thilinasGit/VegaLogger/README.md

# VegaLogger
This repo contains files that is used in telemetery data logger originally used in Vega ETX.
