thilinasGit/VegaLogger/plantFeedpcbModifications.pdf

## Modifications to plant feed board

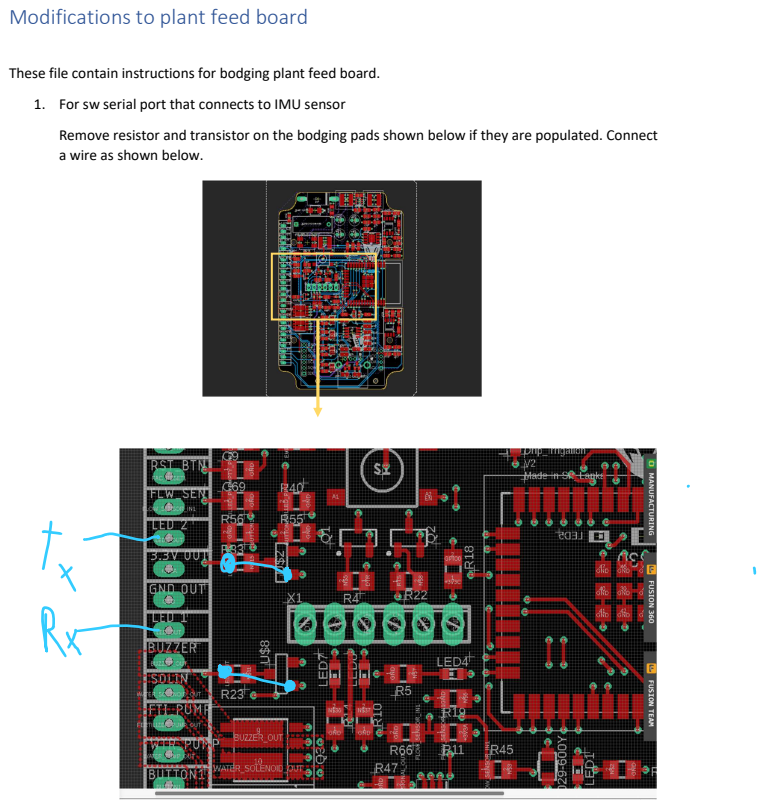
[picture p1: page 1]

These file contain instructions for bodging plant feed board.
1. For sw serial port that connects to IMU sensor
Remove resistor and transistor on the bodging pads shown below if they are populated. Connect
a wire as shown below.

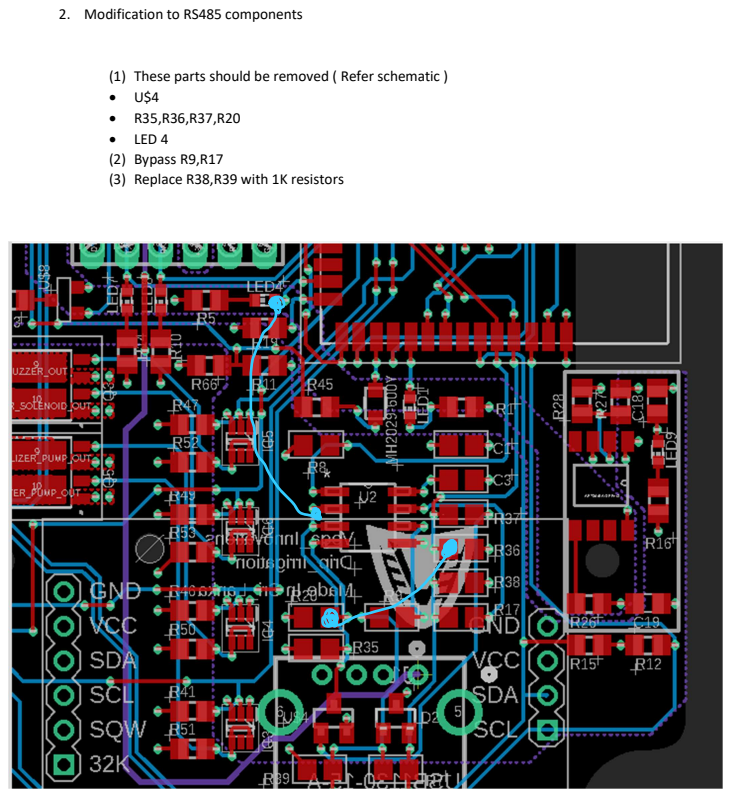
[picture p2: page 2]

2. Modification to RS485 components

(1) These parts should be removed ( Refer schematic )
LED 4
(2) Bypass R9,R17
(3) Replace R38,R39 with 1K resistors
