thilinasGit/VegaLogger/Final.brd

## EAGLE design Final.brd (2023-10-18)

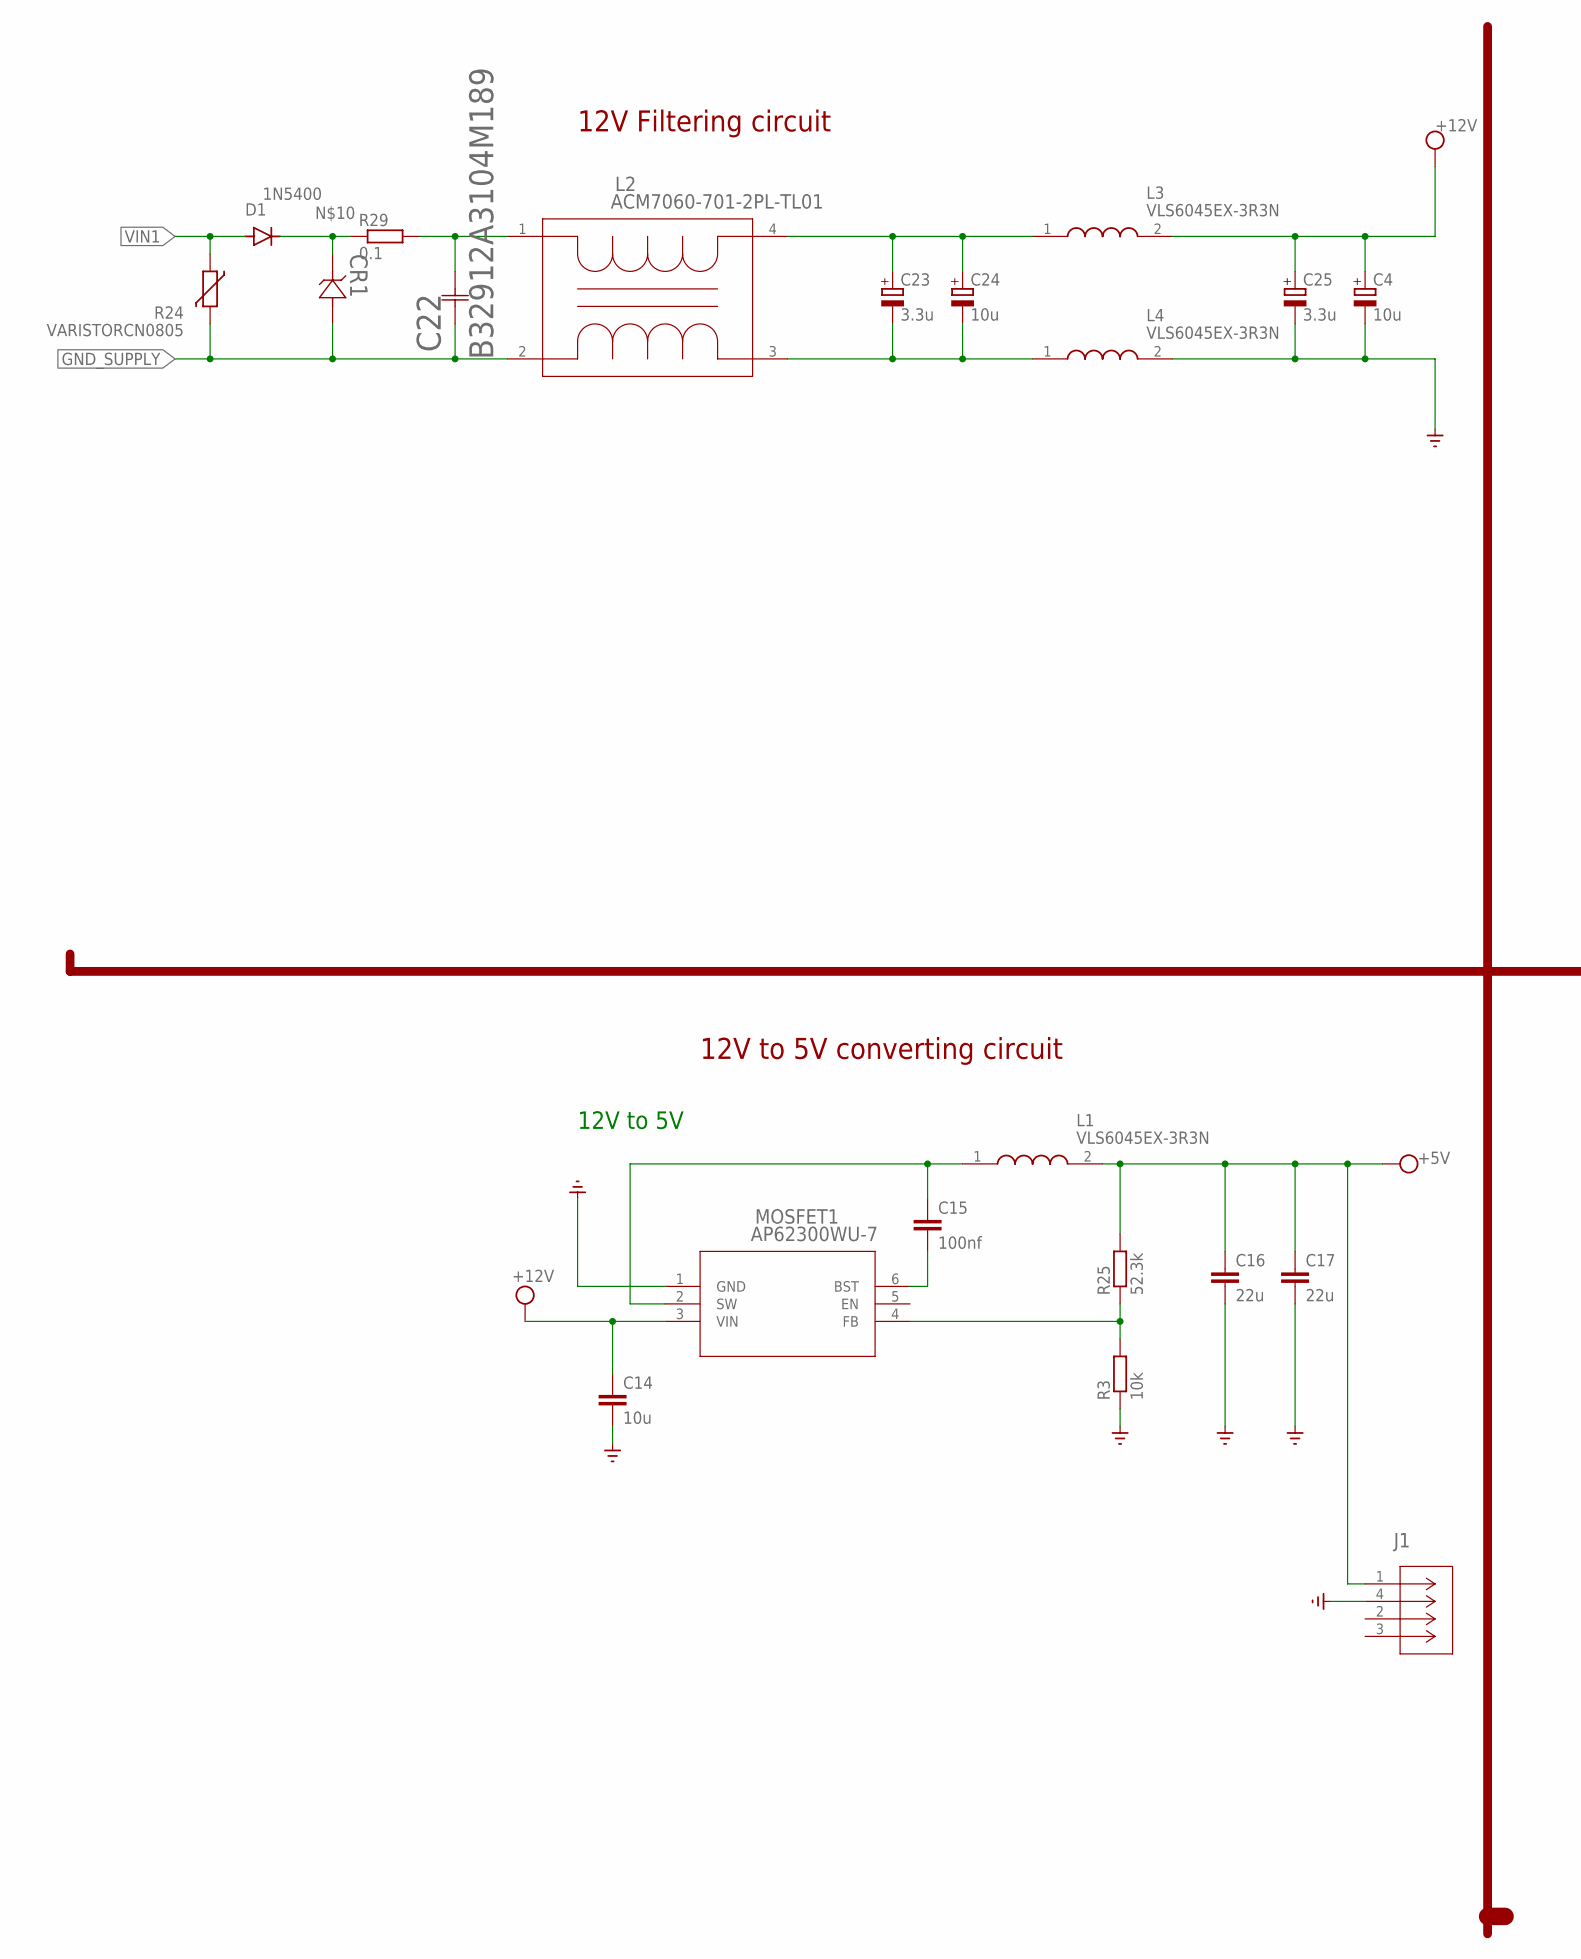
[picture p3: schematic Final.sch, sheet 1, POWER, part in row 1, column 1]

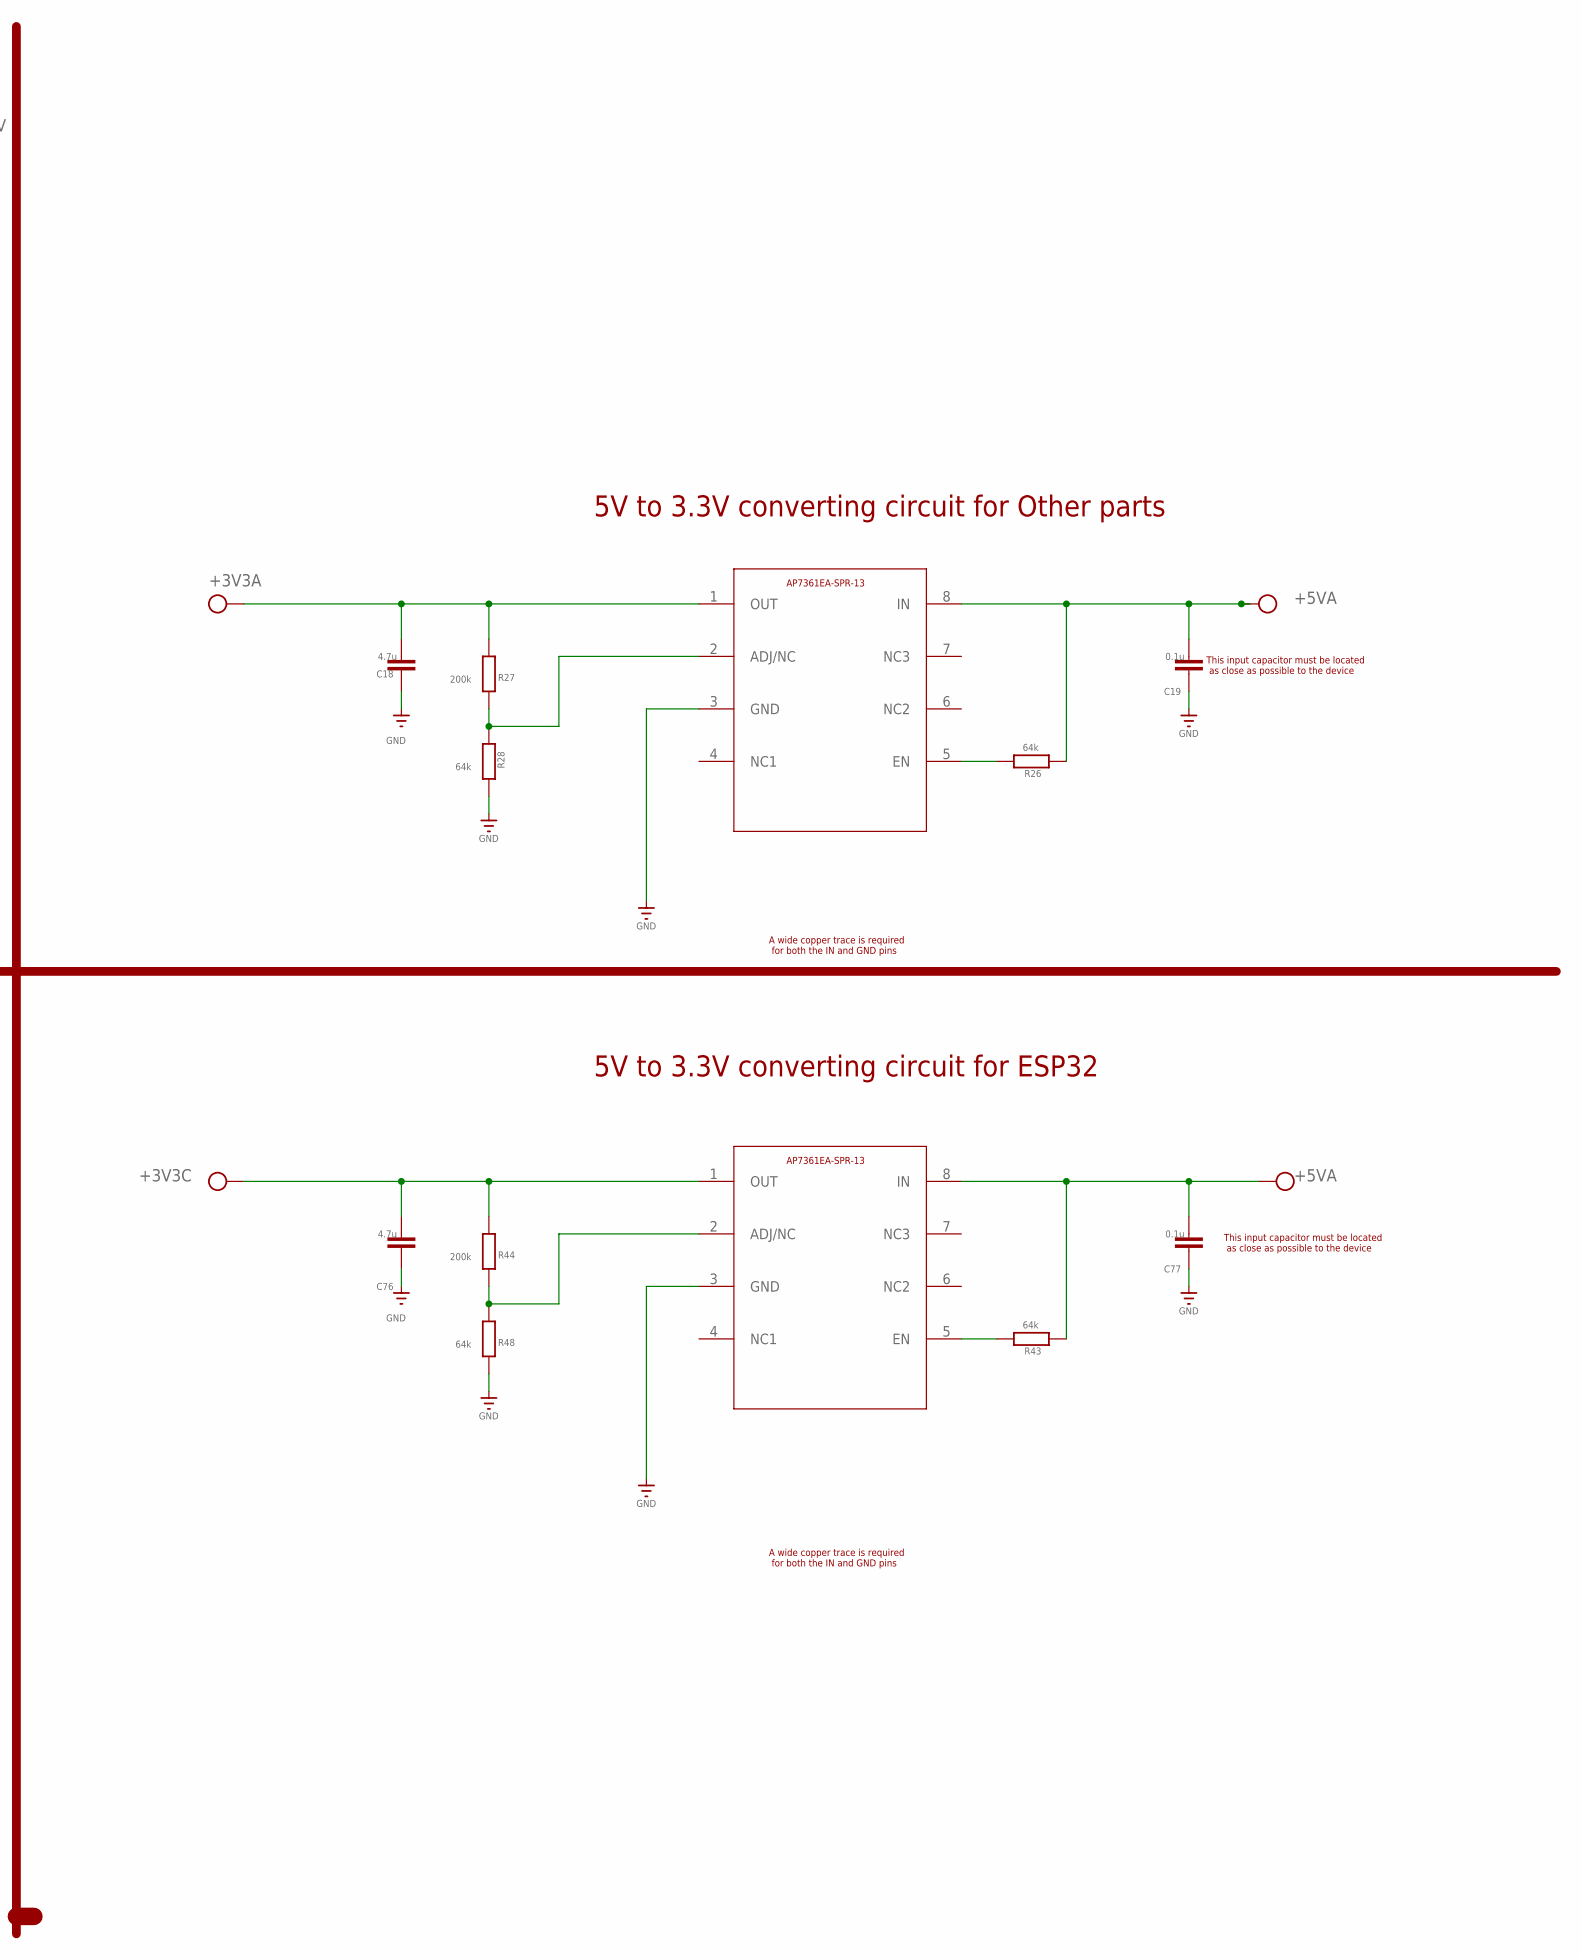
[picture p4: schematic Final.sch, sheet 1, POWER, part in row 1, column 2]

Parts:
C4, C24: 10u; E2,5-5
C14: 10u; C0805
C15: 100nf; C0805
C16, C17: 22u; C0805
C18, C76: 4.7u; C0805
C19, C77: 0.1u; C0805
C22: B32912A3104M189; CAP_B32912A--15--7X12.5X18_TDK
C23, C25: 3.3u; E2,5-5
CR1: SM6T15ASMB_STM-L; SMB_STM-L
D1: 1N5400; DO201-15
J1: USB1130-15-A; CONN4_USB1130-15-A_GCT
L1, L3, L4: VLS6045EX-3R3N; VLS6045
L2: ACM7060-701-2PL-TL01; IND_ACM7060_TDK
MOSFET1: AP62300WU-7; TSOT26_DIO
R3: 10k; R0805
R24: VARISTORCN0805; CT/CN0805
R25: 52.3k; R0805
R26, R28, R43, R48: 64k; R0805
R27, R44: 200k; R0805
R29: 0.1; R1206
U$1, U$12: AP7361EASMD; AP7361EA

Connections:
+3V3A: C18.1, R27.1, U$1.1 (OUT); also elsewhere on the board
+3V3C: C76.1, R44.1, U$12.1 (OUT); also elsewhere on the board
+5V: C16.1, C17.1, J1.1, L1.2, R25.2; also elsewhere on the board
+5VA: C19.1, C77.1, R26.1, R43.1, U$1.8 (IN), U$12.8 (IN); also elsewhere on the board
+12V: C4.+, C14.1, C25.+, L3.2, MOSFET1.3 (VIN); also elsewhere on the board
GND: C4.-, C14.2, C16.2, C17.2, C18.2, C19.2, C25.-, C76.2, C77.2, J1.4, L4.2, MOSFET1.1 (GND), R3.1, R28.2, R48.2, U$1.3 (GND), U$12.3 (GND); also elsewhere on the board
GND_SUPPLY: C22.1, CR1.2, L2.2, R24.2; also elsewhere on the board
unnamed: CR1.1, D1.C, R29.1
unnamed: C23.+, C24.+, L2.4, L3.1
unnamed: C23.-, C24.-, L2.3, L4.1
unnamed: MOSFET1.4 (FB), R3.2, R25.1
unnamed: C15.1, L1.1, MOSFET1.2 (SW)
unnamed: C15.2, MOSFET1.6 (BST)
unnamed: R26.2, U$1.5 (EN)
unnamed: R27.2, R28.1, U$1.2 (ADJ/NC)
unnamed: R43.2, U$12.5 (EN)
unnamed: R44.2, R48.1, U$12.2 (ADJ/NC)
VIN: C22.2, L2.1, R29.2
VIN1: D1.A, R24.1; also elsewhere on the board

Notes on the sheet:
12V to 5V
This input capacitor must be located as close as possible to the device
A wide copper trace is required for both the IN and GND pins
12V Filtering circuit
12V to 5V converting circuit
5V to 3.3V converting circuit for ESP32
5V to 3.3V converting circuit for Other parts

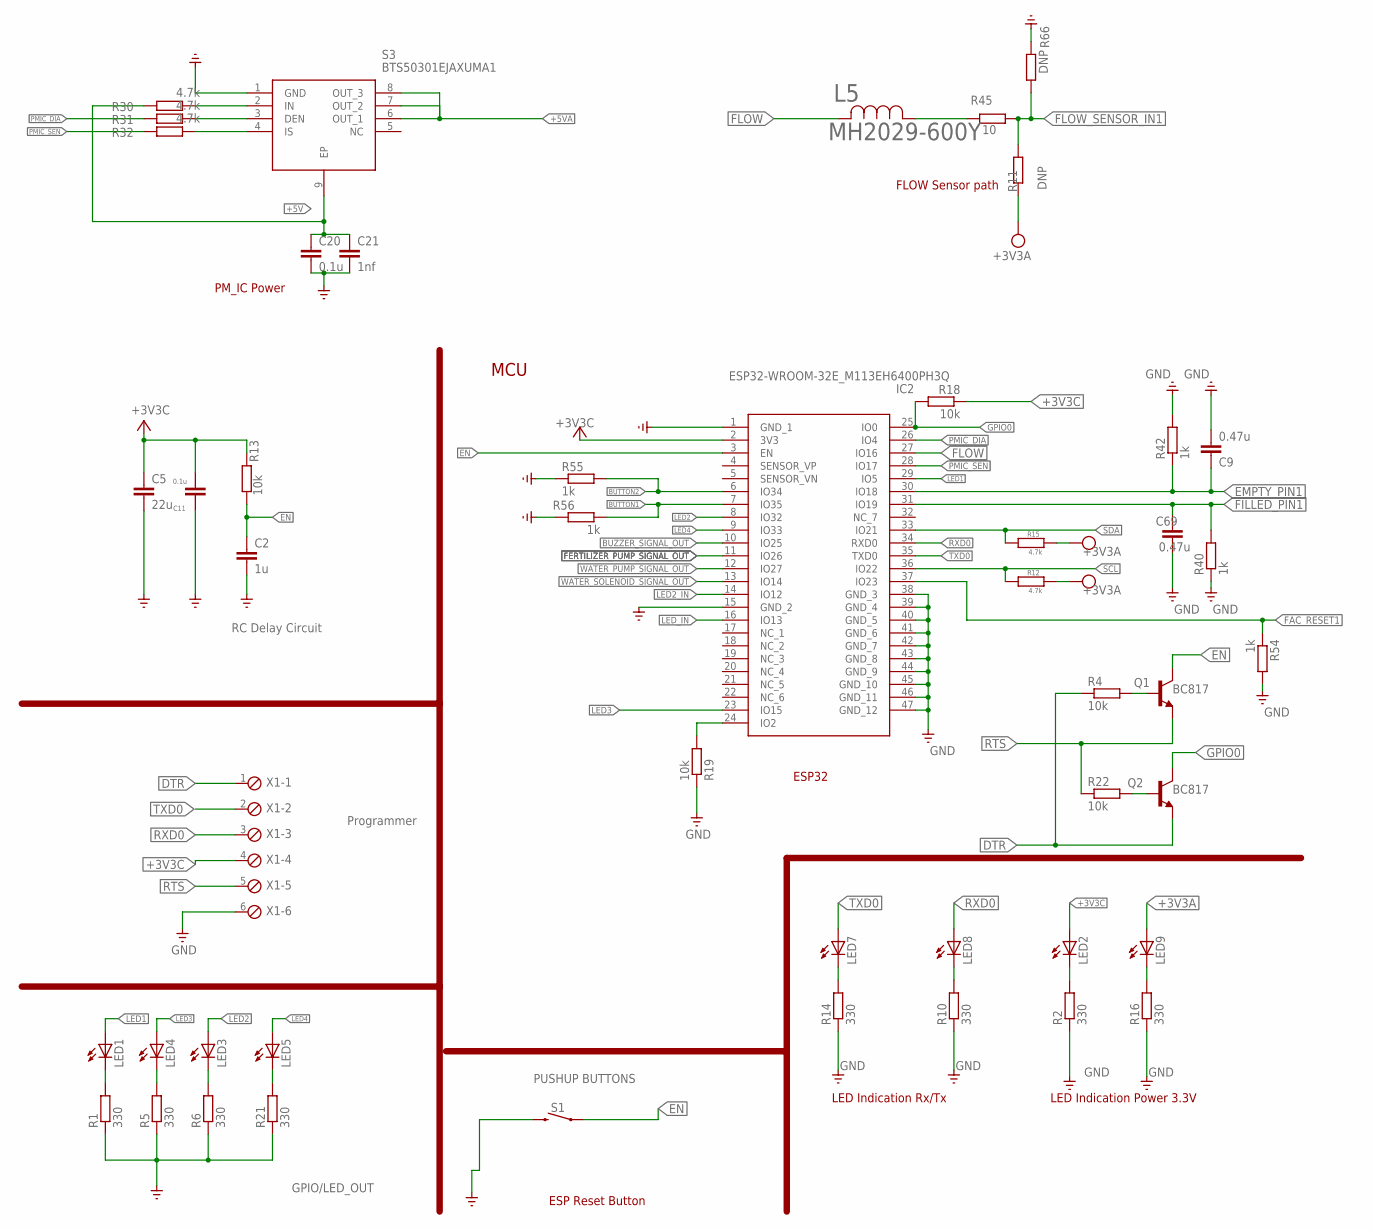
[picture p5: schematic Final.sch, sheet 2, ESP32]

Parts:
C2: 1u; C0805
C5: 22u; C0805
C9, C69: 0.47u; C0805
C11, C20: 0.1u; C0805
C21: 1nf; C0805
IC2: ESP32-WROOM-32E_M113EH6400PH3Q; ESP32WROOM32EM113EH6400PH3Q0
L5: MH2029-600Y; IND_BOURNS_MH2029
LED1, LED2, LED3, LED4, LED5, LED7, LED8, LED9: LEDCHIP-LED0603; CHIP-LED0603
Q1, Q2: BC817; SOT95P230X110-3N
R1, R2, R5, R6, R10, R14, R16, R21: 330; R0805
R4, R13, R18, R19, R22: 10k; R0805
R11, R66: DNP; R0805
R12, R15, R30, R31, R32: 4.7k; R0805
R40, R42, R54, R55, R56: 1k; R0805
R45: 10; R0805
S1: MOMENTARY-SWITCH-SPST-SMD-6.2MM-TALL; TACTILE_SWITCH_SMD_6.2MM_TALL
S3: BTS50301EJAXUMA1; SOIC127P600X170-9N
X1: MPT6; 6POL254

Connections:
+3V3A: LED9.A, R11.2, R12.1, R15.1; also elsewhere on the board
+3V3C: C5.1, C11.2, IC2.2 (3V3), LED2.A, R13.1, R18.1, X1.4; also elsewhere on the board
+5V: C20.1, C21.1, R30.1, S3.9 (EP); also elsewhere on the board
+5VA: S3.6 (OUT_1), S3.7 (OUT_2), S3.8 (OUT_3); also elsewhere on the board
BUTTON1: IC2.7 (IO35), R56.1; also elsewhere on the board
BUTTON2: IC2.6 (IO34), R55.2; also elsewhere on the board
BUZZER_SIGNAL_OUT: IC2.10 (IO25); also elsewhere on the board
DTR: Q2.2 (E), R4.1, X1.1
EMPTY_PIN1: C9.1, IC2.30 (IO18), R42.1; also elsewhere on the board
EN: C2.1, IC2.3 (EN), Q1.3 (C), R13.2, S1.A2 (1)
FAC_RESET1: IC2.37 (IO23), R54.1; also elsewhere on the board
FERTILIZER_PUMP_SIGNAL_OUT: IC2.11 (IO26); also elsewhere on the board
FILLED_PIN1: C69.1, IC2.31 (IO19), R40.2; also elsewhere on the board
FLOW: IC2.27 (IO16), L5.2
FLOW_SENSOR_IN1: R11.1, R45.1, R66.1; also elsewhere on the board
GND: C2.2, C5.2, C9.2, C11.1, C20.2, C21.2, C69.2, IC2.1 (GND_1), IC2.15 (GND_2), IC2.38 (GND_3), IC2.39 (GND_4), IC2.40 (GND_5), IC2.41 (GND_6), IC2.42 (GND_7), IC2.43 (GND_8), IC2.44 (GND_9), IC2.45 (GND_10), IC2.46 (GND_11), IC2.47 (GND_12), R1.1, R2.1, R5.1, R6.1, R10.1, R14.1, R16.1, R19.1, R21.1, R40.1, R42.2, R54.2, R55.1, R56.2, R66.2, S1.B2 (2), S3.1 (GND), X1.6; also elsewhere on the board
GPIO0: IC2.25 (IO0), Q2.3 (C), R18.2
LED1: IC2.29 (IO5), LED1.A
LED2: IC2.8 (IO32), LED3.A
LED2_IN: IC2.14 (IO12); also elsewhere on the board
LED3: IC2.23 (IO15), LED4.A
LED4: IC2.9 (IO33), LED5.A
LED_IN: IC2.16 (IO13); also elsewhere on the board
unnamed: LED2.C, R2.2
unnamed: LED1.C, R1.2
unnamed: L5.1, R45.2
unnamed: LED3.C, R6.2
unnamed: Q1.1 (B), R4.2
unnamed: IC2.24 (IO2), R19.2
unnamed: LED4.C, R5.2
unnamed: Q2.1 (B), R22.2
unnamed: LED5.C, R21.2
unnamed: R30.2, S3.2 (IN)
unnamed: R31.2, S3.3 (DEN)
unnamed: R32.2, S3.4 (IS)
unnamed: LED7.C, R14.2
unnamed: LED8.C, R10.2
unnamed: LED9.C, R16.2
PMIC_DIA: IC2.26 (IO4), R31.1
PMIC_SEN: IC2.28 (IO17), R32.1
RTS: Q1.2 (E), R22.1, X1.5
RXD0: IC2.34 (RXD0), LED8.A, X1.3; also elsewhere on the board
SCL: IC2.36 (IO22), R12.2; also elsewhere on the board
SDA: IC2.33 (IO21), R15.2; also elsewhere on the board
TXD0: IC2.35 (TXD0), LED7.A, X1.2; also elsewhere on the board
WATER_PUMP_SIGNAL_OUT: IC2.12 (IO27); also elsewhere on the board
WATER_SOLENOID_SIGNAL_OUT: IC2.13 (IO14); also elsewhere on the board

Notes on the sheet:
GPIO/LED_OUT
RC Delay Circuit
LED Indication Power 3.3V
PUSHUP BUTTONS
MCU
Programmer
LED Indication Rx/Tx
ESP Reset Button
ESP32
PM_IC Power
FLOW Sensor path

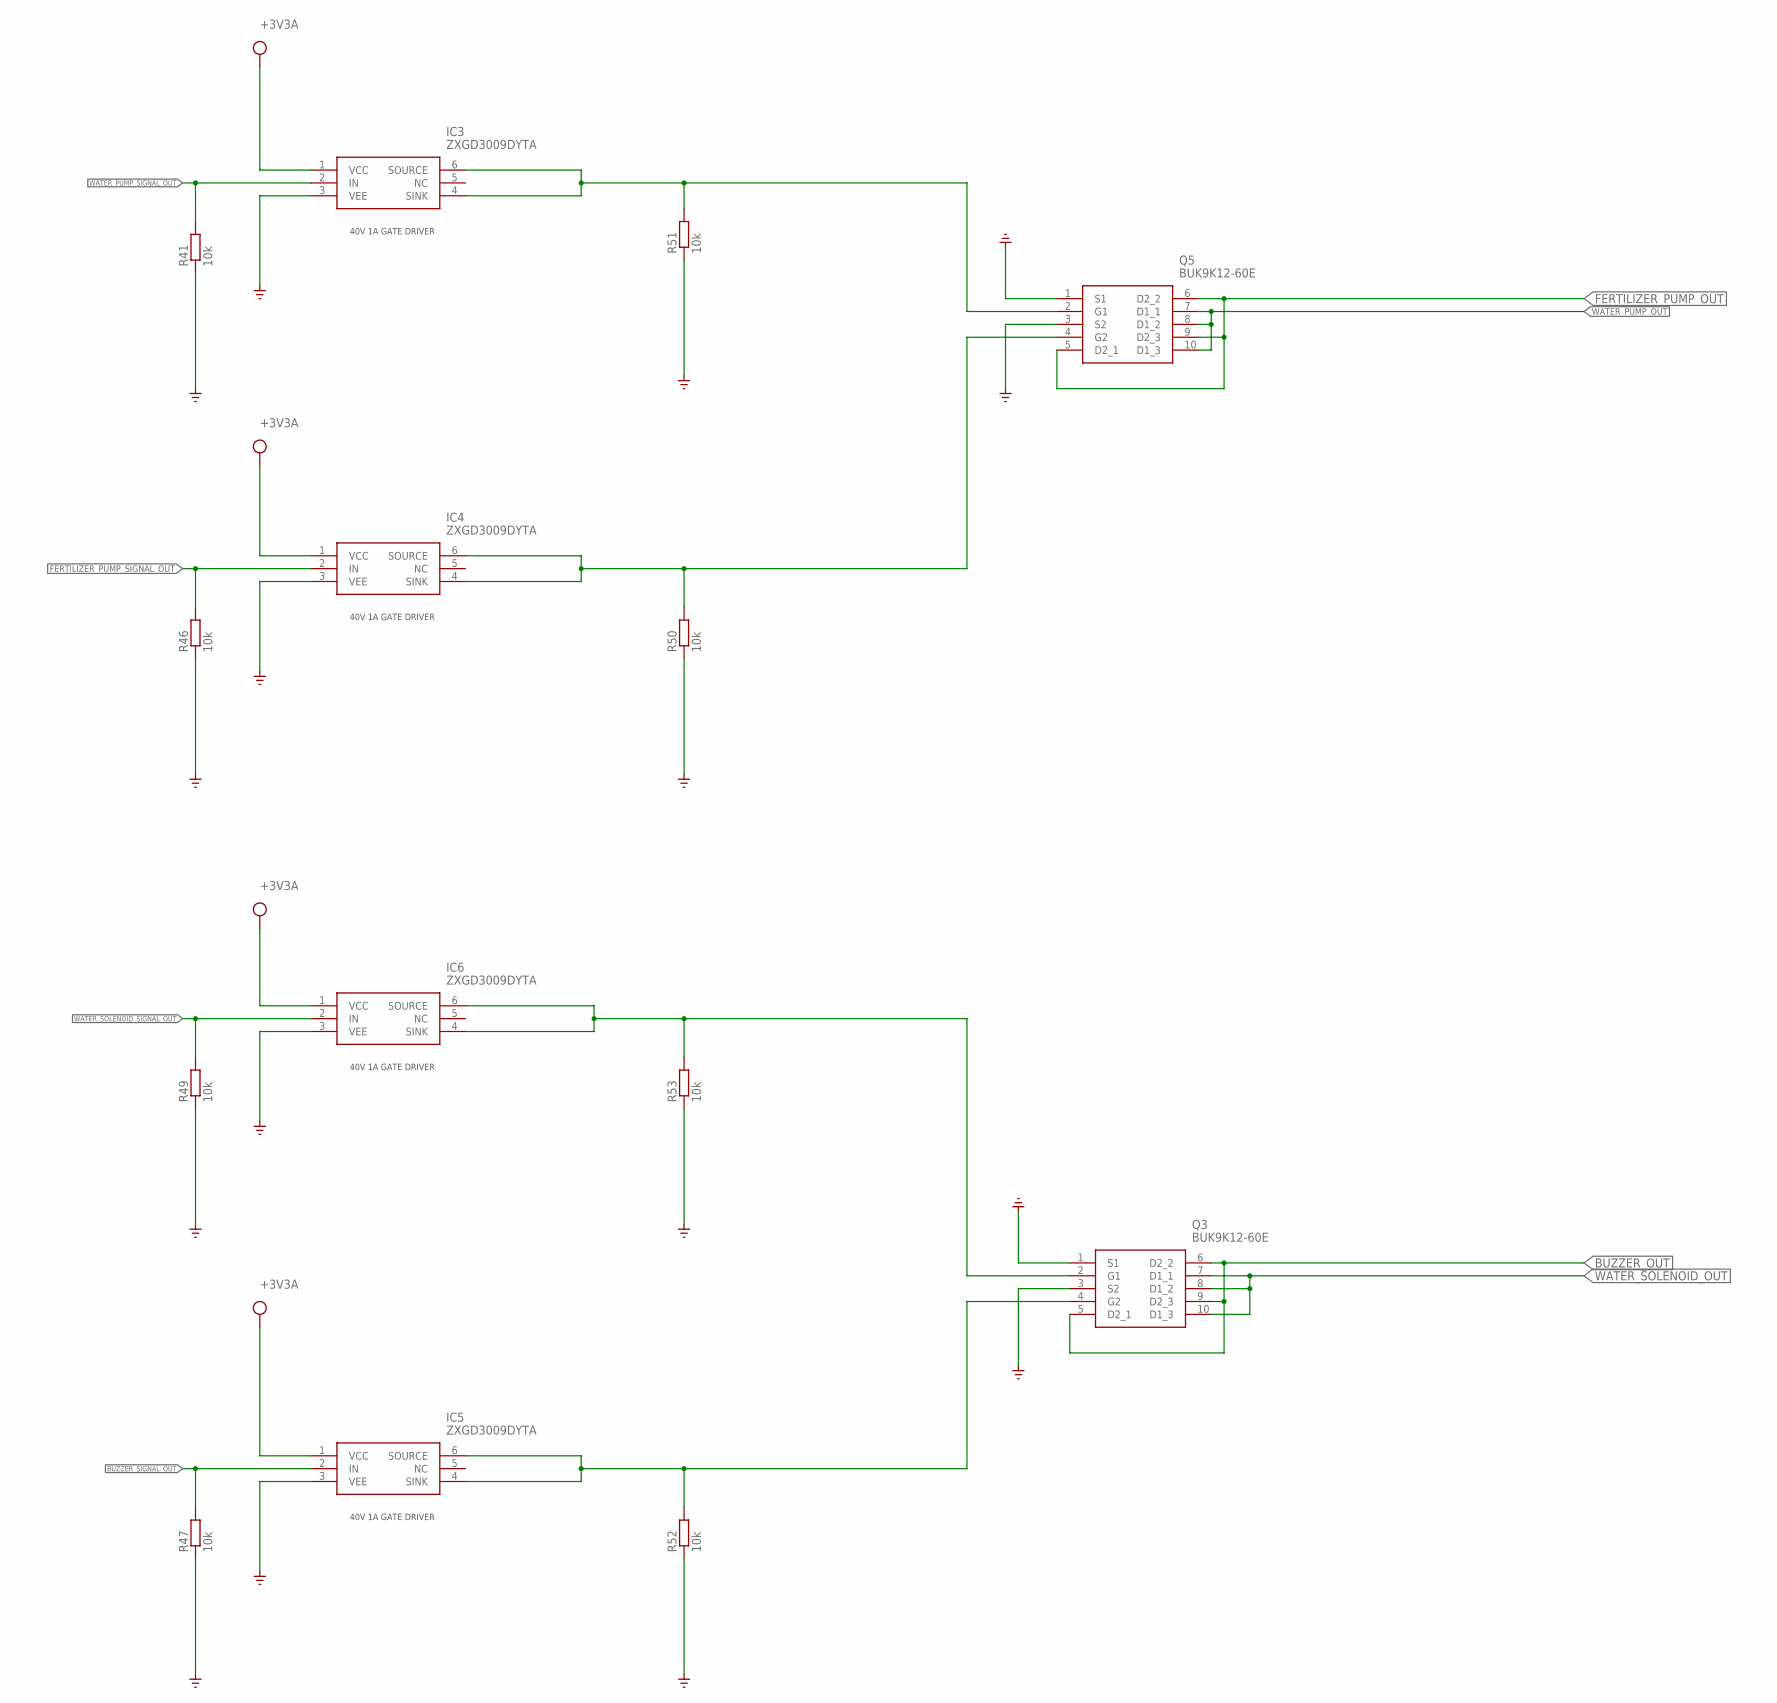
[picture p6: schematic Final.sch, sheet 3, Drivers]

Parts:
IC3, IC4, IC5, IC6: ZXGD3009DYTA; SOT65P210X110-6N
Q3, Q5: BUK9K12-60E
R41, R46, R47, R49, R50, R51, R52, R53: 10k; R0805

Connections:
+3V3A: IC3.1 (VCC), IC4.1 (VCC), IC5.1 (VCC), IC6.1 (VCC); also elsewhere on the board
BUZZER_OUT: Q3.5 (D2_1), Q3.6 (D2_2), Q3.9 (D2_3); also elsewhere on the board
BUZZER_SIGNAL_OUT: IC5.2 (IN), R47.2; also elsewhere on the board
FERTILIZER_PUMP_OUT: Q5.5 (D2_1), Q5.6 (D2_2), Q5.9 (D2_3); also elsewhere on the board
FERTILIZER_PUMP_SIGNAL_OUT: IC4.2 (IN), R46.2; also elsewhere on the board
GND: IC3.3 (VEE), IC4.3 (VEE), IC5.3 (VEE), IC6.3 (VEE), Q3.1 (S1), Q3.3 (S2), Q5.1 (S1), Q5.3 (S2), R41.1, R46.1, R47.1, R49.1, R50.1, R51.1, R52.1, R53.1; also elsewhere on the board
unnamed: IC3.4 (SINK), IC3.6 (SOURCE), Q5.2 (G1), R51.2
unnamed: IC4.4 (SINK), IC4.6 (SOURCE), Q5.4 (G2), R50.2
unnamed: IC5.4 (SINK), IC5.6 (SOURCE), Q3.4 (G2), R52.2
SOLENOID: IC6.4 (SINK), IC6.6 (SOURCE), Q3.2 (G1), R53.2
WATER_PUMP_OUT: Q5.7 (D1_1), Q5.8 (D1_2), Q5.10 (D1_3); also elsewhere on the board
WATER_PUMP_SIGNAL_OUT: IC3.2 (IN), R41.2; also elsewhere on the board
WATER_SOLENOID_OUT: Q3.7 (D1_1), Q3.8 (D1_2), Q3.10 (D1_3); also elsewhere on the board
WATER_SOLENOID_SIGNAL_OUT: IC6.2 (IN), R49.2; also elsewhere on the board

Notes on the sheet:
40V 1A GATE DRIVER

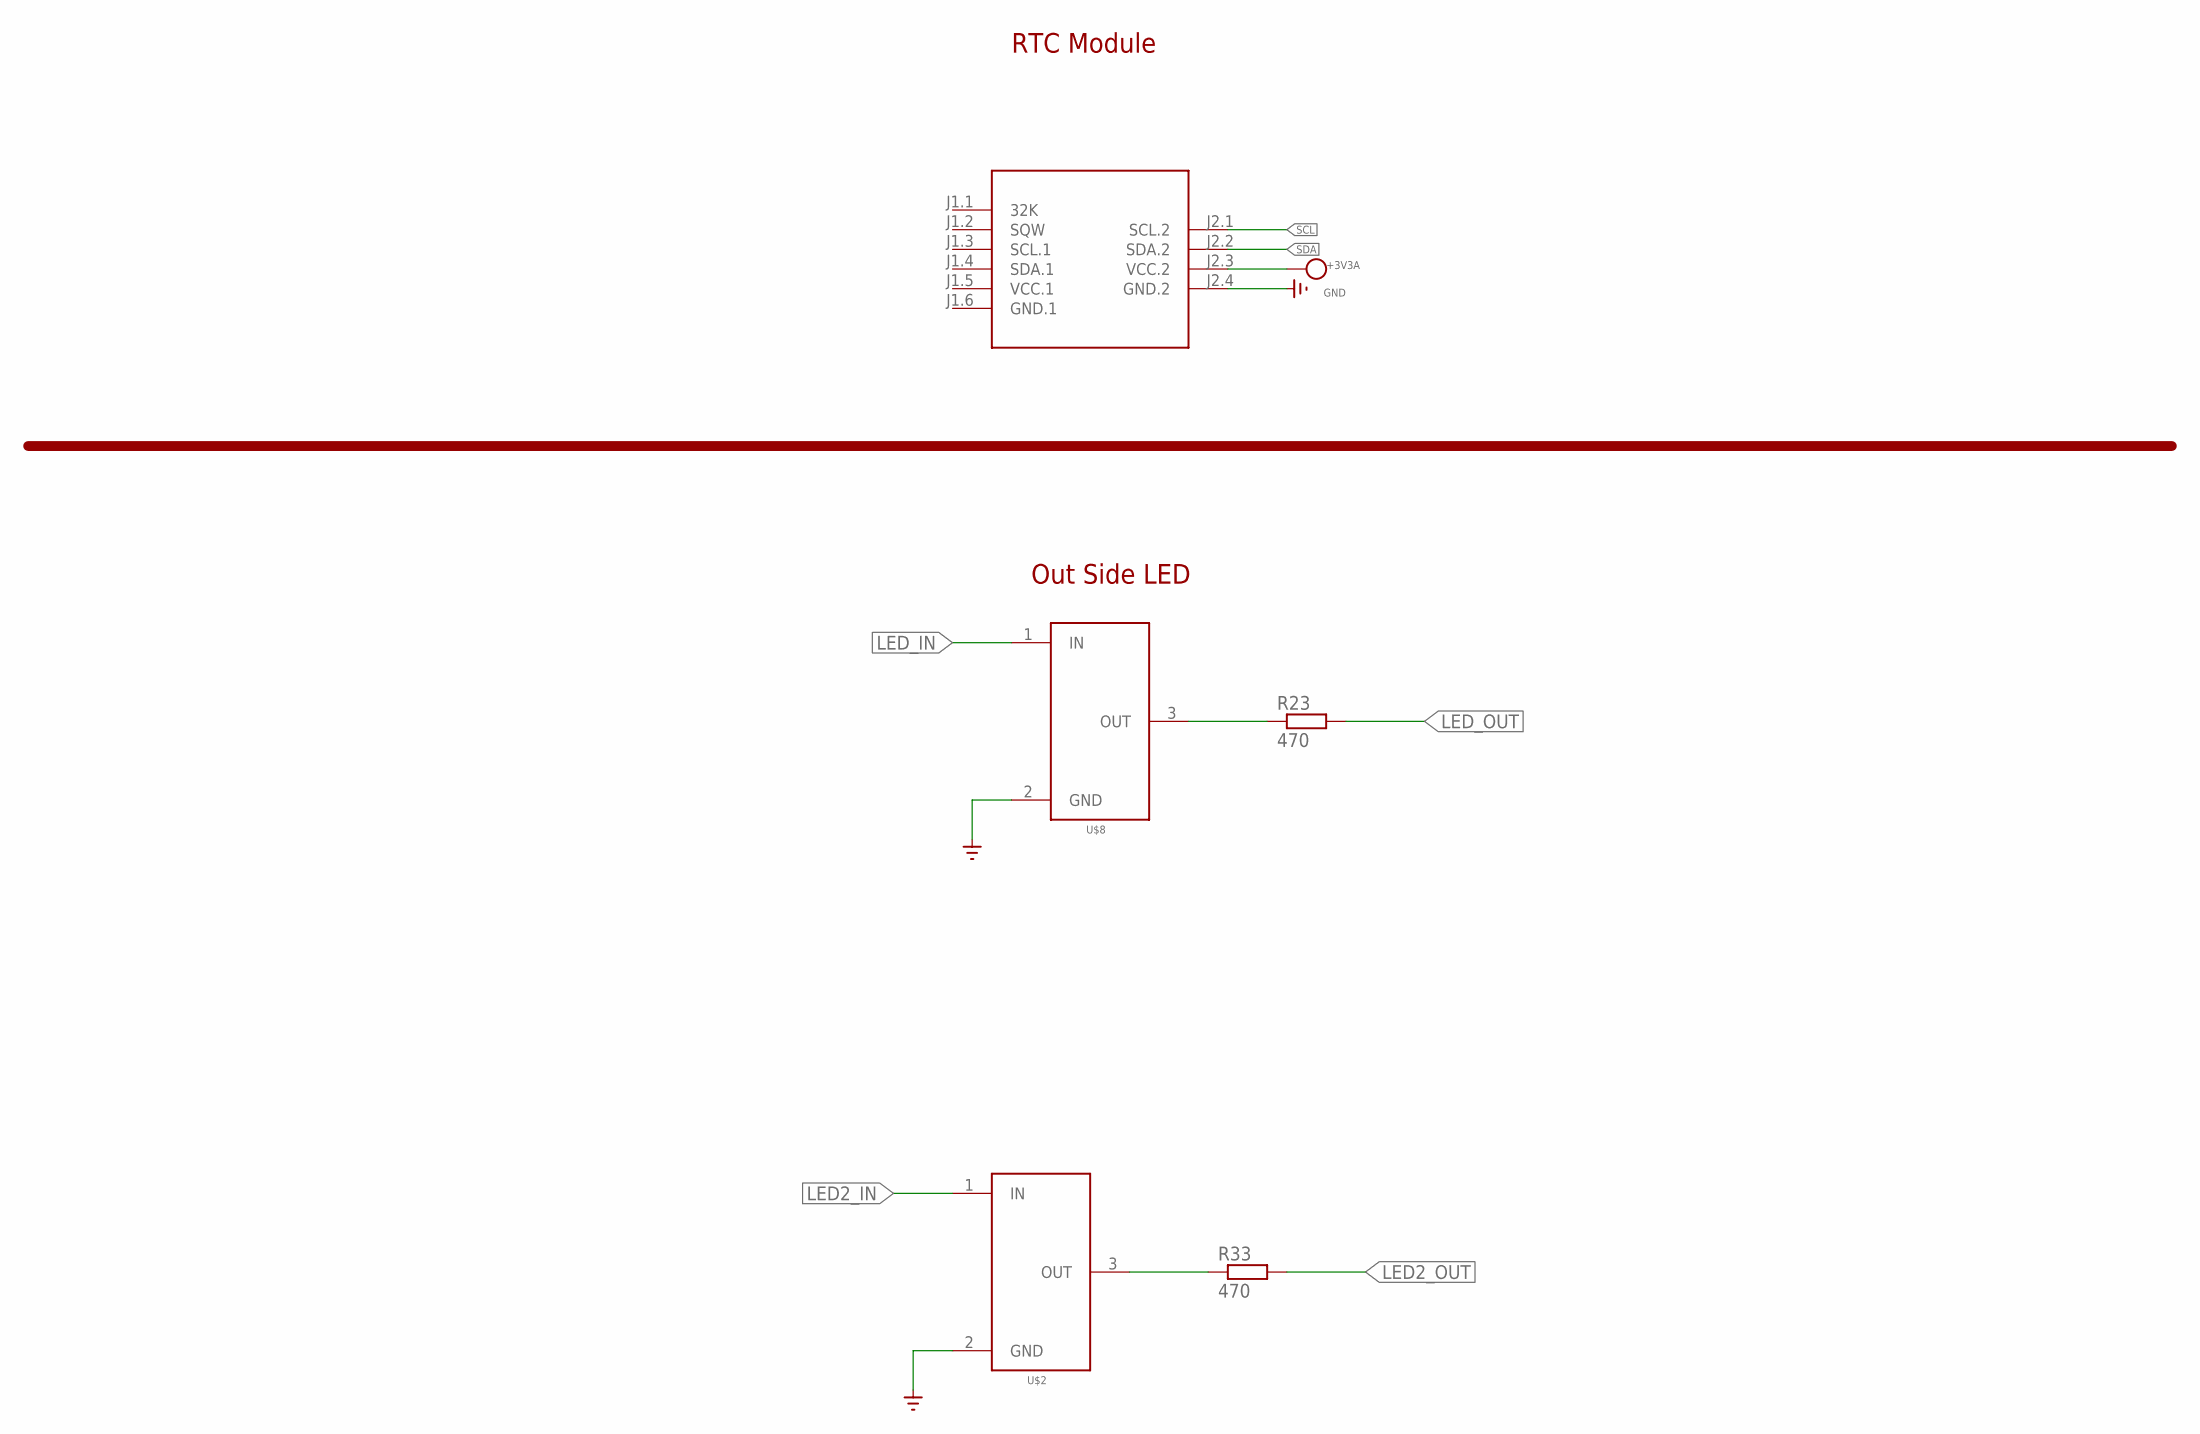
[picture p7: schematic Final.sch, sheet 4, RTC Module]

Parts:
R23, R33: 470; R0805
U$2, U$8: DDTD113ZC-7-F
U$3: RTC-DS3231-AT24C32

Connections:
+3V3A: U$3.J2.3 (VCC.2); also elsewhere on the board
GND: U$2.2 (GND), U$3.J2.4 (GND.2), U$8.2 (GND); also elsewhere on the board
GND.1: U$3.J1.6 (GND.1)
LED2_IN: U$2.1 (IN); also elsewhere on the board
LED2_OUT: R33.2; also elsewhere on the board
LED_IN: U$8.1 (IN); also elsewhere on the board
LED_OUT: R23.2; also elsewhere on the board
unnamed: R23.1, U$8.3 (OUT)
unnamed: R33.1, U$2.3 (OUT)
SCL: U$3.J2.1 (SCL.2); also elsewhere on the board
SDA: U$3.J2.2 (SDA.2); also elsewhere on the board
VCC.1: U$3.J1.5 (VCC.1)

Notes on the sheet:
RTC Module
Out Side LED

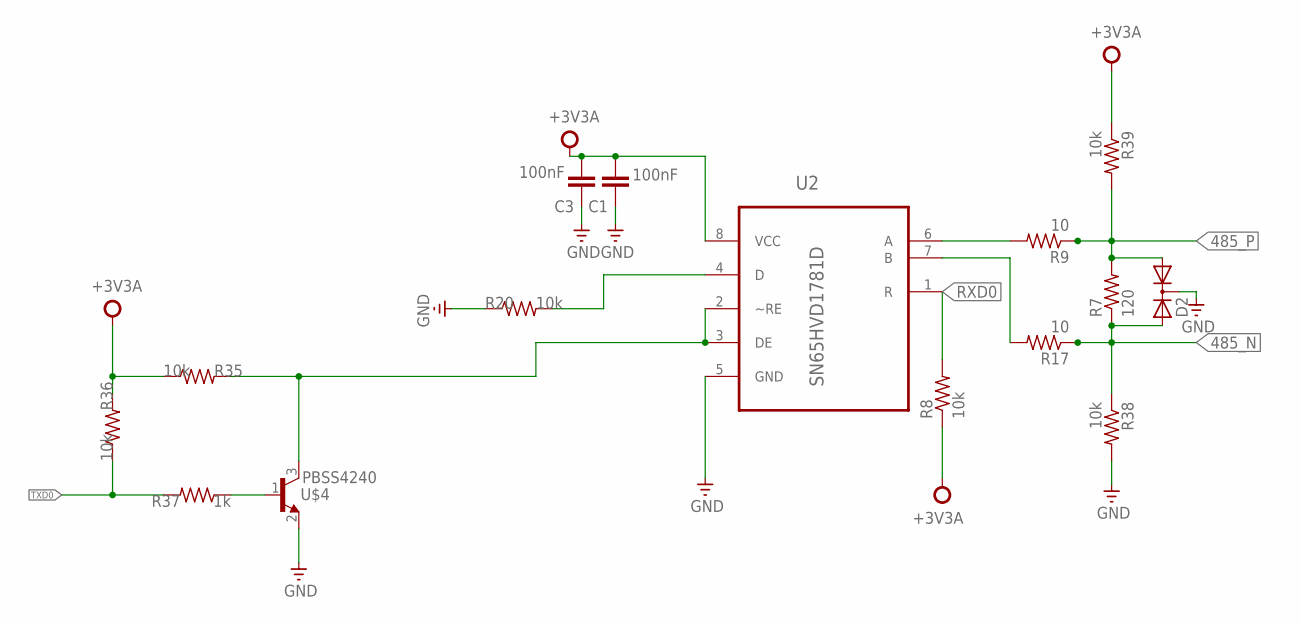
[picture p8: schematic Final.sch, sheet 5, RS485 Auto Tranresiver]

Parts:
C1, C3: 100nF; C0805
D2: DIODE-2AC|CASOT23; SOT23
R7: 120; R0805
R8, R20, R35, R36, R38, R39: 10k; R0805
R9, R17: 10; R0805
R37: 1k; R0805
U2: SN65HVD1781D; SOIC127P600X175-8N
U$4: PBSS4240; SOT23

Connections:
485_N: D2.2 (A2), R7.1, R17.1, R38.1; also elsewhere on the board
485_P: D2.1 (A1), R7.2, R9.1, R39.2; also elsewhere on the board
+3V3A: C1.2, C3.2, R8.1, R35.1, R36.2, R39.1, U2.8 (VCC); also elsewhere on the board
GND: C1.1, C3.1, D2.3 (C), R20.1, R38.2, U2.5 (GND), U$4.2 (E); also elsewhere on the board
unnamed: R9.2, U2.6 (A)
unnamed: R17.2, U2.7 (B)
unnamed: R20.2, U2.4 (D)
unnamed: R35.2, U2.2 (~RE), U2.3 (DE), U$4.3 (C)
unnamed: R37.1, U$4.1 (B)
RXD0: R8.2, U2.1 (R); also elsewhere on the board
TXD0: R36.1, R37.2; also elsewhere on the board

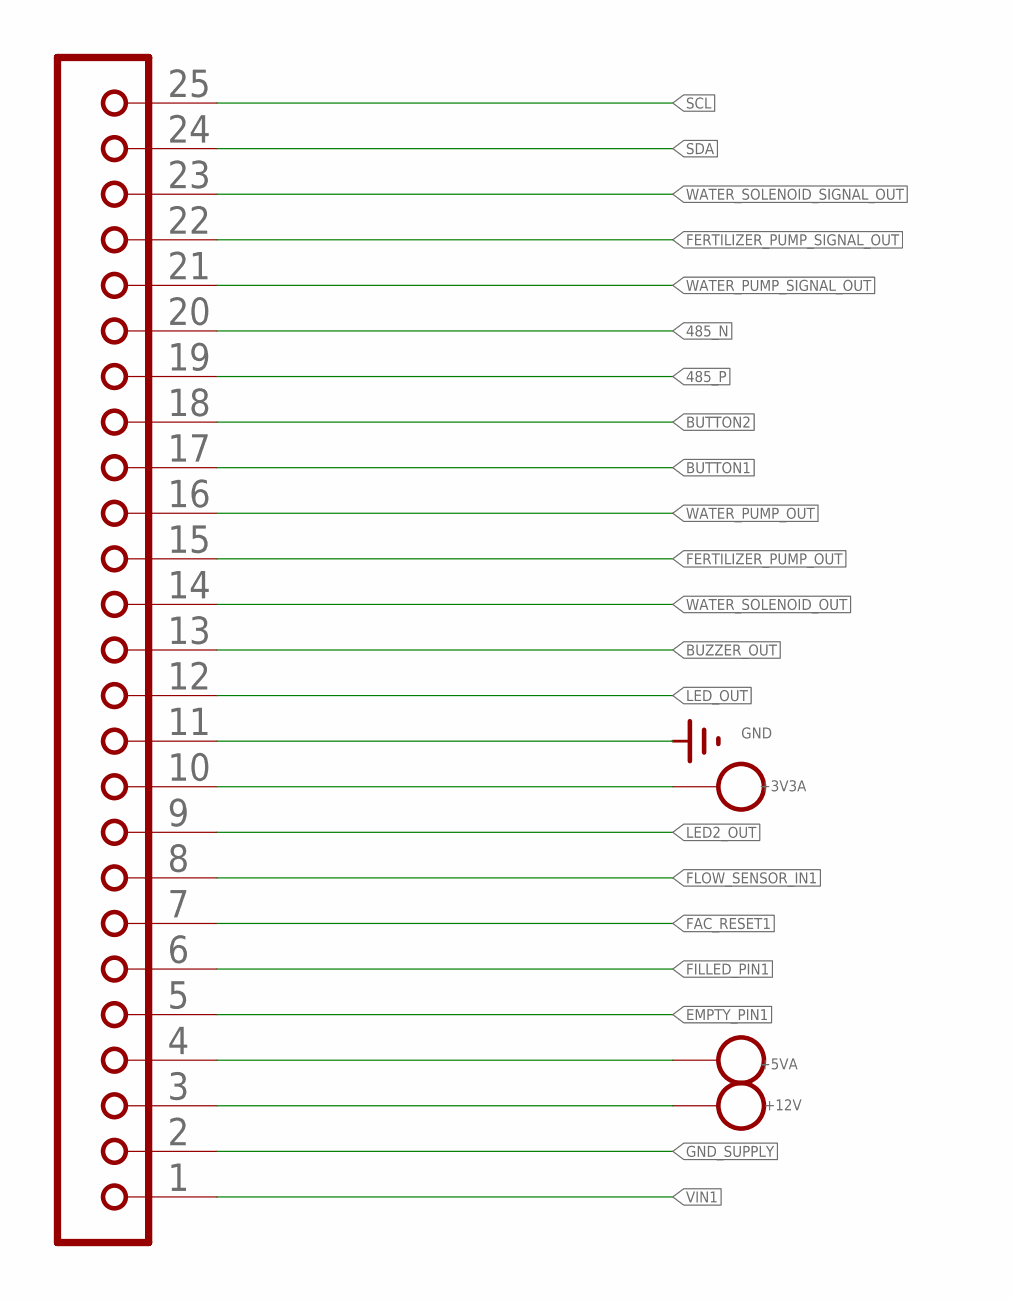
[picture p9: schematic Final.sch, sheet 6, Connectors]

Parts:
J2: JBK20L

Connections:
485_N: J2.20; also elsewhere on the board
485_P: J2.19; also elsewhere on the board
+3V3A: J2.10; also elsewhere on the board
+5VA: J2.4; also elsewhere on the board
+12V: J2.3; also elsewhere on the board
BUTTON1: J2.17; also elsewhere on the board
BUTTON2: J2.18; also elsewhere on the board
BUZZER_OUT: J2.13; also elsewhere on the board
EMPTY_PIN1: J2.5; also elsewhere on the board
FAC_RESET1: J2.7; also elsewhere on the board
FERTILIZER_PUMP_OUT: J2.15; also elsewhere on the board
FERTILIZER_PUMP_SIGNAL_OUT: J2.22; also elsewhere on the board
FILLED_PIN1: J2.6; also elsewhere on the board
FLOW_SENSOR_IN1: J2.8; also elsewhere on the board
GND: J2.11; also elsewhere on the board
GND_SUPPLY: J2.2; also elsewhere on the board
LED2_OUT: J2.9; also elsewhere on the board
LED_OUT: J2.12; also elsewhere on the board
SCL: J2.25; also elsewhere on the board
SDA: J2.24; also elsewhere on the board
VIN1: J2.1; also elsewhere on the board
WATER_PUMP_OUT: J2.16; also elsewhere on the board
WATER_PUMP_SIGNAL_OUT: J2.21; also elsewhere on the board
WATER_SOLENOID_OUT: J2.14; also elsewhere on the board
WATER_SOLENOID_SIGNAL_OUT: J2.23; also elsewhere on the board
