thilinasGit/VegaLogger/Final.brd

## EAGLE design Final.brd (continued)

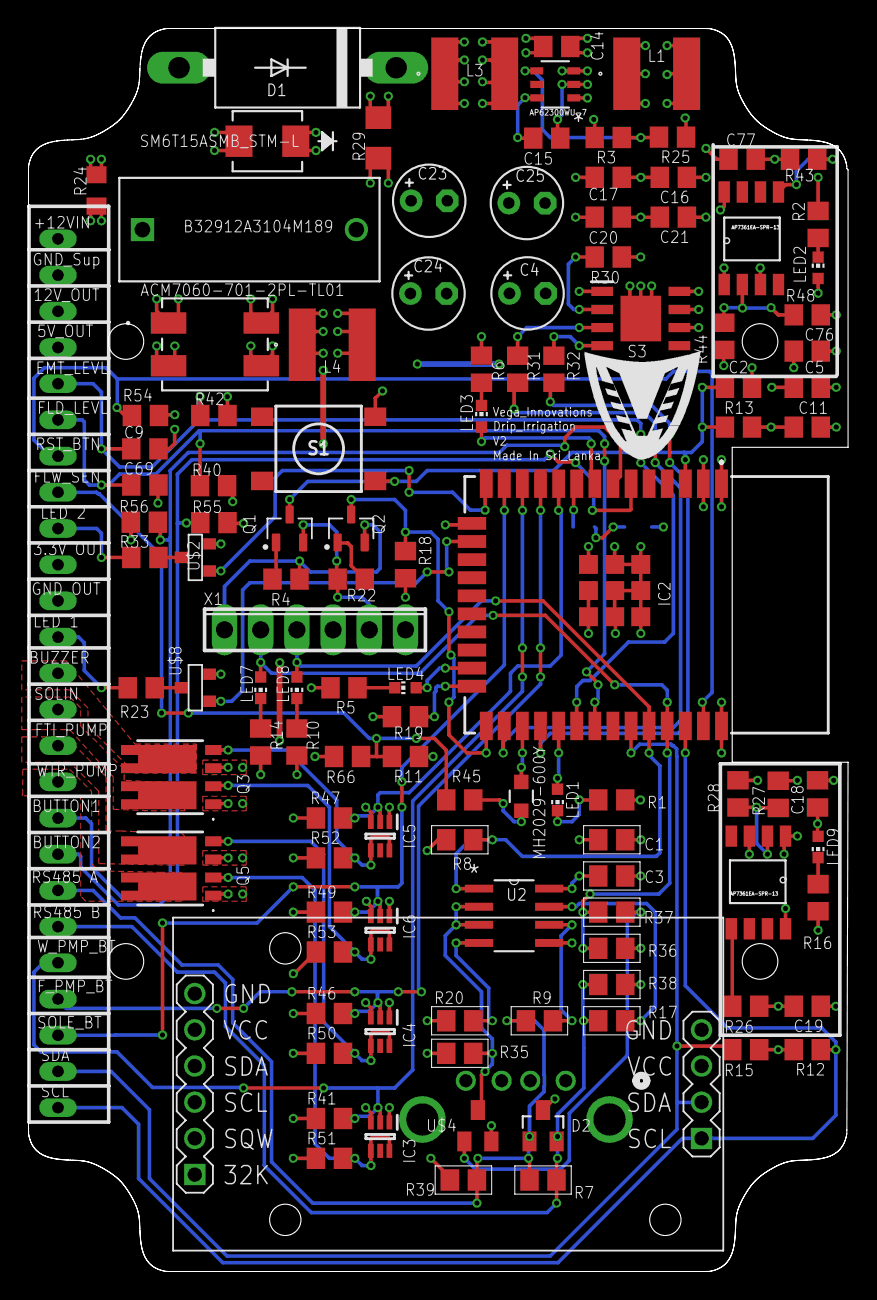
[picture p10: board Final.brd from above]

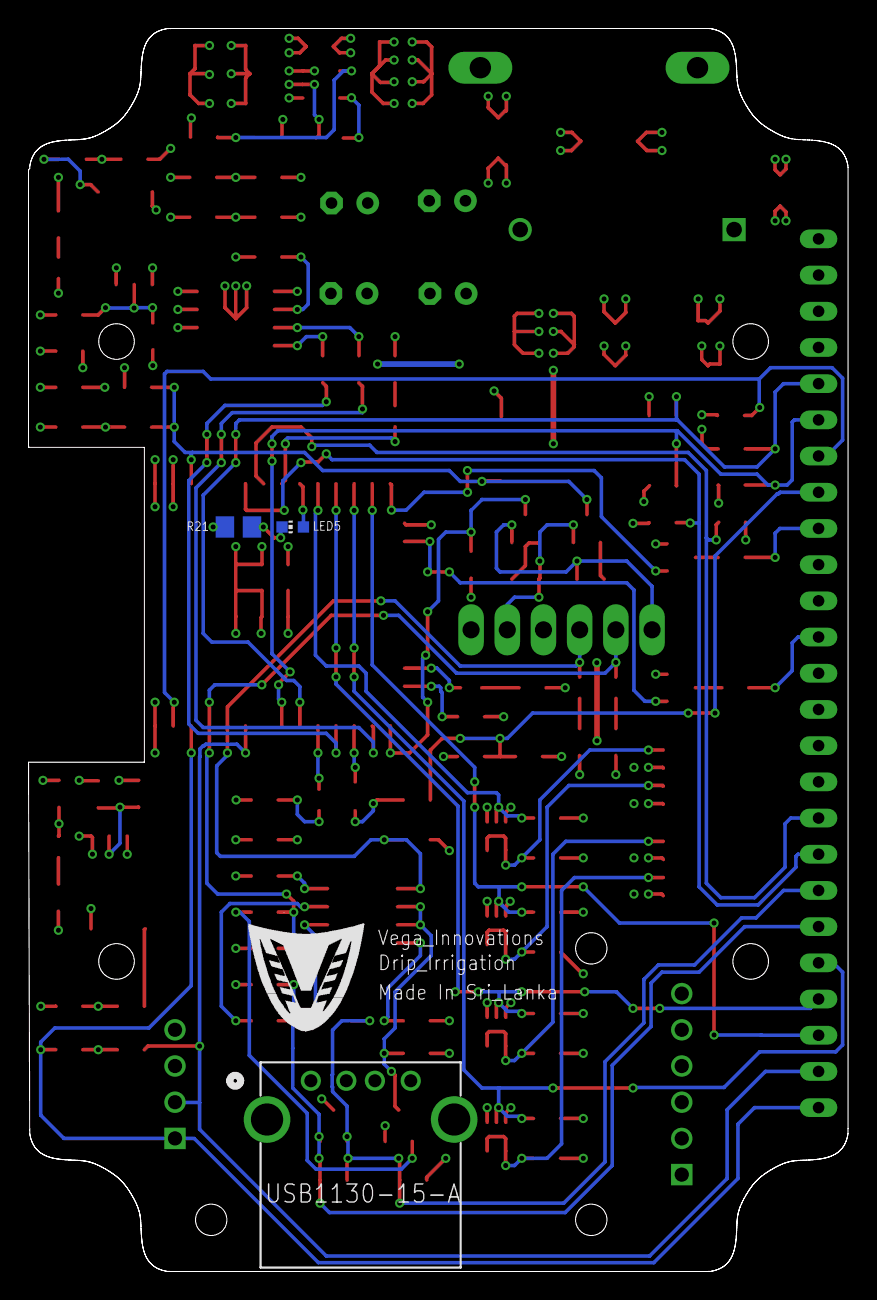
[picture p11: board Final.brd from below]

Board: 4 copper layers, 57.5 x 87.2 mm, 116 parts (3 on the bottom side), 80 nets.
